NJ-2384/Oorja/(commit log)

2024-09-10 Rename Version 1 - (Transmitter).ino to v1_Transmitter (Arduino).ino
2024-09-10 Rename RECIEVER.ino to v1_Receiver (Arduino).ino
2024-09-10 Rename ESP_T.ino to v2_Transmitter (ESP32).ino
2024-09-10 Rename ESP_R.ino to v2_Reciever (ESP32).ino
2024-09-10 Update v1_Receiver (Arduino).ino
2024-09-10 Update v1_Transmitter (Arduino).ino
2024-09-10 Update v2_Reciever (ESP32).ino
2024-09-10 Update v2_Transmitter (ESP32).ino
2024-09-19 Rename v1_Receiver (Arduino).ino to Version 1/v1_Receiver (Arduino).ino
2024-09-19 Rename v1_Transmitter (Arduino).ino to Version 1/v1_Transmitter (Arduino).ino
2024-09-19 Rename v2_Reciever (ESP32).ino to Version 2/v2_Reciever (ESP32).ino
2024-09-19 Rename v2_Transmitter (ESP32).ino to Version 2/v2_Transmitter (ESP32).ino
2024-09-19 Rename v2_Reciever (ESP32).ino to Reciever (ESP32).ino
2024-09-19 Rename v2_Transmitter (ESP32).ino to Transmitter (ESP32).ino
2024-09-19 Rename v1_Receiver (Arduino).ino to Receiver (Arduino).ino
2024-09-19 Rename v1_Transmitter (Arduino).ino to Transmitter (Arduino).ino
